p-rivero/CESCA/CESC Computer/README.md

# CESC Computer

This is the first iteration of the CESC computer. It's built on breadboards, and it's heavily inspired by Ben Eater's SAP-1 computer (the clock module and decimal decoder are identical).

The clock speed can be adjusted (with a potentiometer) up to **80 kHz**, but the circuit should be able to run at much higher speeds (however, that would require a crystal oscillator instead of the limited 555 circuit).

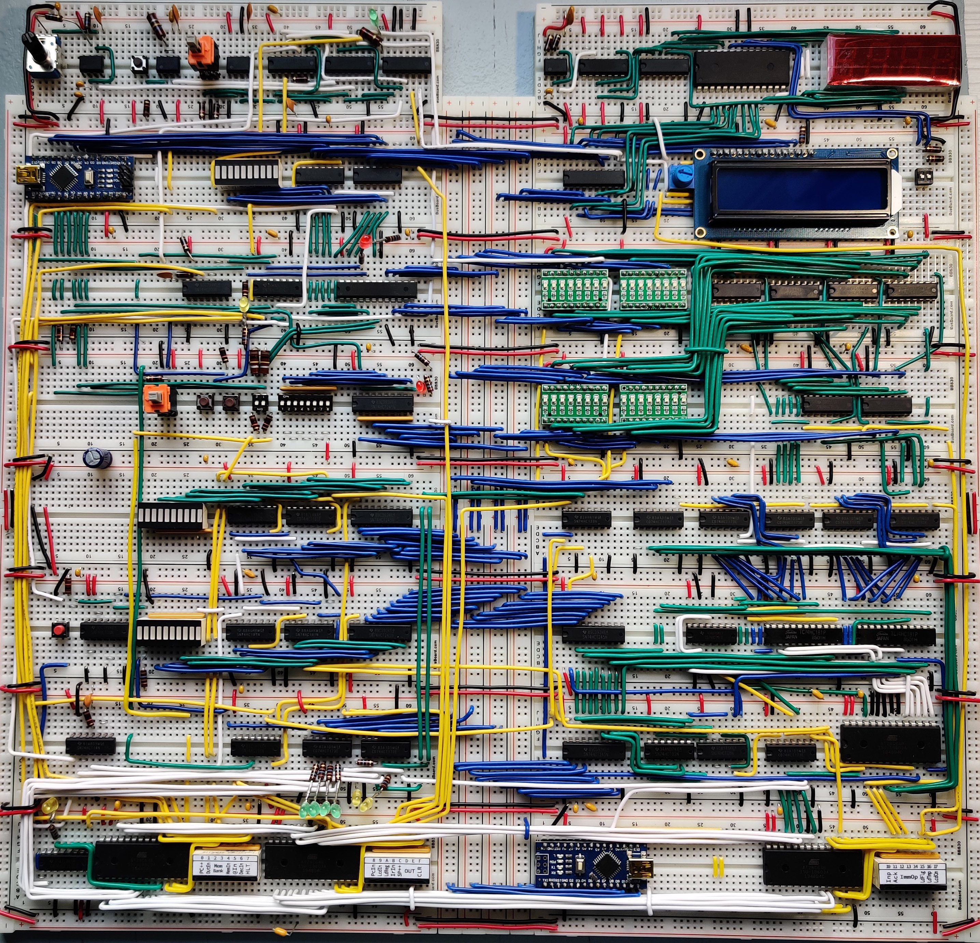
[picture p1: CESC Computer/Pictures/Computer.jpg]
Computer


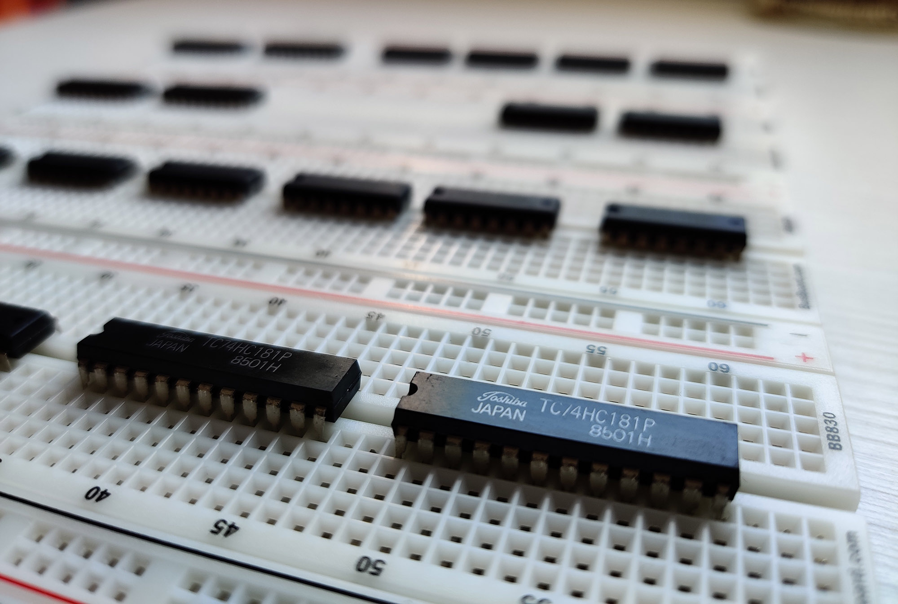
[picture p2: CESC Computer/Pictures/ALU_Chips.jpg]
Computer


## Modules

Just like in Ben Eater's design, the computer is split in several modules that are connected to a main bus in the middle.

However, unlike the SAP-1, my computer does make use of microcontrollers for I/O. Some will say this is cheating, but I'm allowing it because the CPU itself is still made out of discrete logic chips (it works just fine without any microcontroller, it's just that the I/O is less convenient).

- Arduino Nano for programming the RAM (instead of having to use the DIP switches)
- Arduino Nano for interfacing with a PS/2 keyboard
- LCD module (like the one used in Ben Eater's 6502 series)

Computer modules

## PS/2 Keyboard demo

Computer modules
