p-rivero/CESCA/CESC Computer/Control labels/README.md

# Control labels

This image is meant to be printed and then taped on top of the 10 segment bar graphs for the control word.
It's based on the [8bit-labels by w3arycod3r](https://github.com/w3arycod3r/8bit-labels).

**Warning**: Unlike the original labels, the size of this file isn't the real size of the bar graphs. Using "Actual size" in Adobe Reader isn't enough.

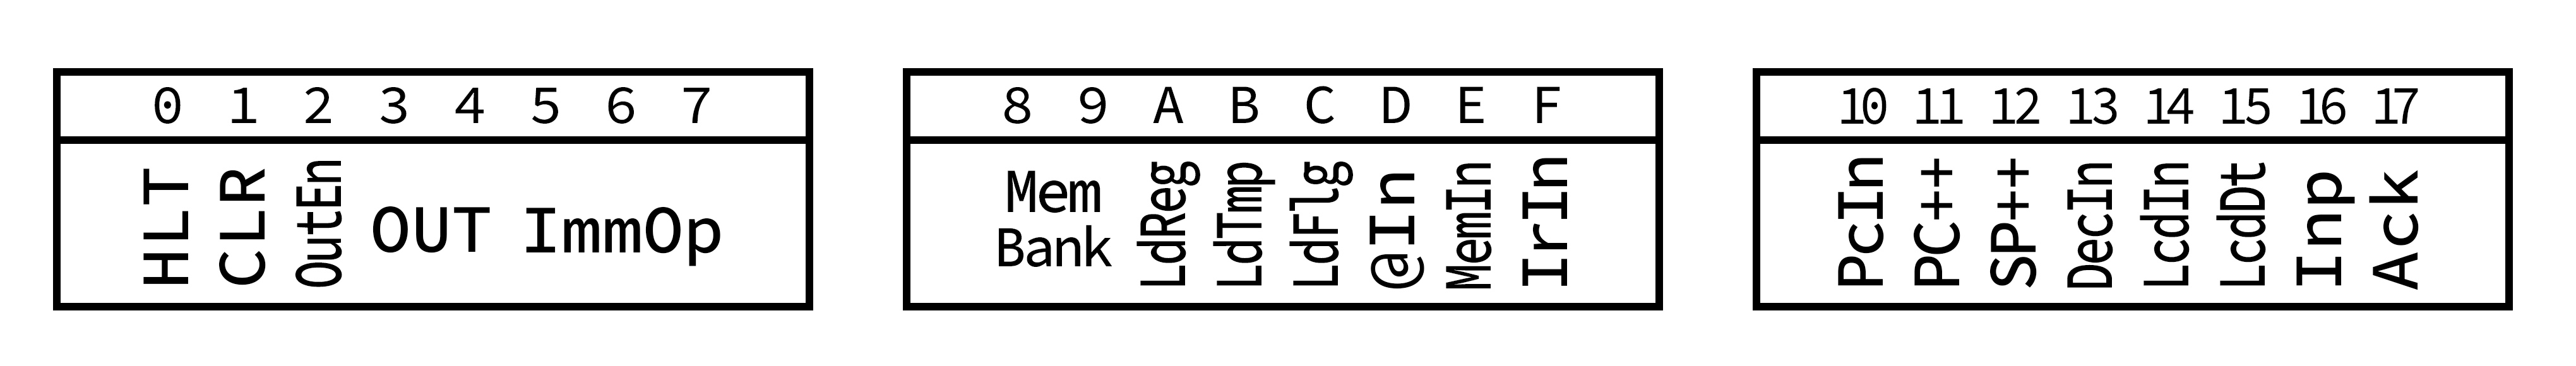
[picture p6: CESC Computer/Control labels/control labels.jpg]
Control labels


## New distribution

In order to greatly improve wiring, the distribution of the signals inside the EEPROMs has been changed. The new labels can be found in the `New distribution` folder.

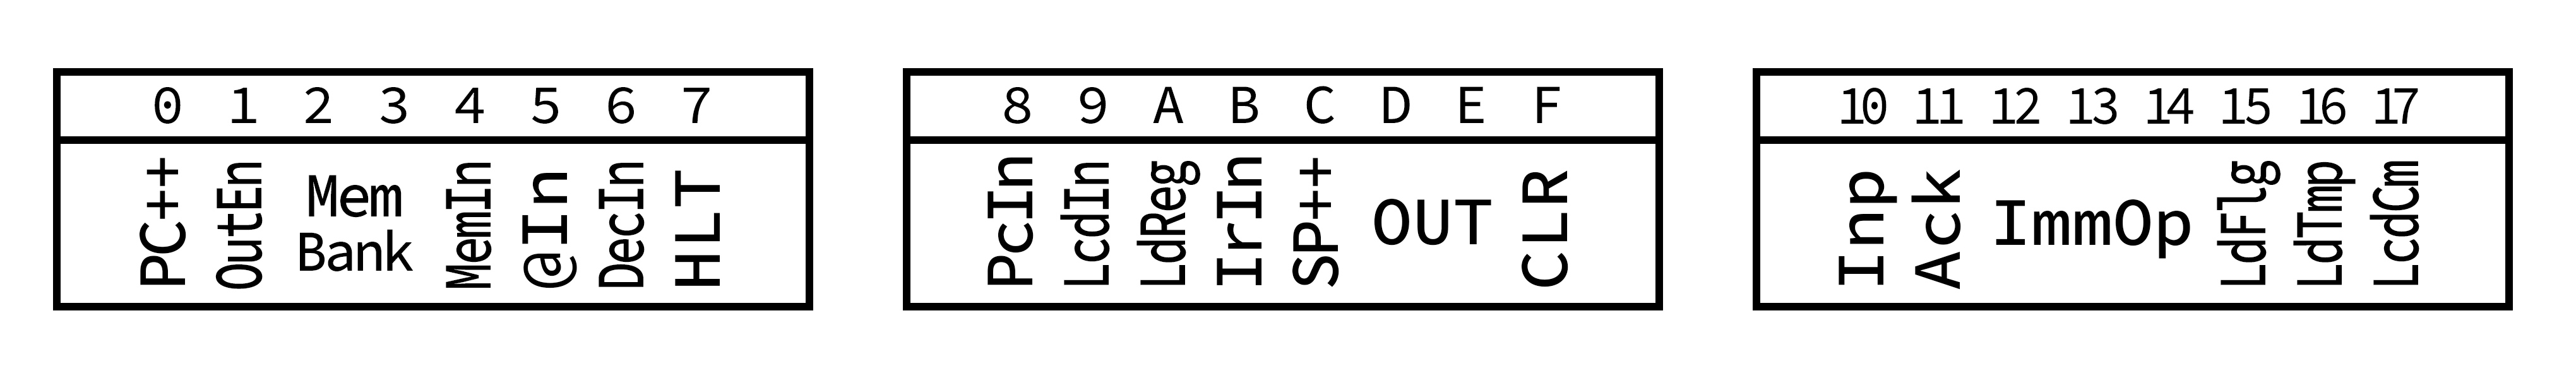
[picture p7: CESC Computer/Control labels/New distribution/control labels.jpg]
New control labels
