p-rivero/CESCA/Documentation/Keyboard_interface.pdf

# CESCA Keyboard Interface:

Contents of the keyboard controller:

Invalid input: No key has been pressed since the last check, or it’s still being processed. This state can be easily detected using maskIN,0xFF followed by a jz.

ASCII character: The pressed key corresponds to an ASCII character. If the input expected a number, you can subtract 48 (ASCII code for ‘0’) to the input. Note the following:
- The NULL character is interpreted as the invalid input.
- The Enter key is considered a special key instead of the ASCII code for CR or LF.
- The Backspace (delete) key is considered a special key instead of the ASCII code for BS or DEL.
- The input gets triggered when the key is pressed down

Special keys: If a program only expects to receive the arrow keys and other special keys, this format allows it to easily read them using an immediate mask.
- Special keys trigger twice: when it’s pressed down (make) and then when it’s lifted up (break).

Del = Backspace key or Delete key
Key Break: 0 = The key was pressed down (make) 1 = The key was lifted up (break)

Typematic Repeat: If a key is kept down, the keyboard will continue sending keystrokes at regular intervals. This affects both ASCII and Special keys, but the Key Break of special keys will always be sent only once.

Keypress buffer: The Arduino keyboard controller has an input buffer, so an input can be accepted even if previous ones are still being processed. The input buffer can be wiped by restarting the Arduino.

Input register (8 bits)

0 | 0 | 0 | 0 | 0 | 0 | 0 | 0

Input register (8 bits)

0 | ASCII code (7 bits)

Input register (8 bits)

1 | Key Break | Enter | Del

Generic input controller:
The computer can accept input from any device, as long as its controller meets these requirements:
- Must appear as a register: The computer expects an 8 bit “Input register”, with outputs connected directly to the bus and in a high impedance state by default.
- Invalid input: If Input register contains 0x00 as its value, the input is considered invalid. This means the user hasn’t entered any input yet, or that the controller is still processing it. The controller can decide how to represent its data using 8 bits, as long as it’s not with a 0x00.
- Takes 2 control signals:
- Inp (Input): Output enable signal for the Input register. The contents of the register are published to the bus for as long as Inp is high.
- Ack (Acknowledge): When Ack is high, the computer is indicating that it has finished processing the current input. The contents of the Input register must get set to 0x00 and the controller can start accepting a new input, or processing the next input in its buffer. Note that Ack will only be active if the current contents of the Input register aren’t 0x00, and Ack and Inp will never be active at the same time.
- Timing: The controller must follow these timing requirements:
- Enable output: The contents of the bus will be read half a clock cycle after the Inp signal gets set to high.
- Disable output: After the Inp signal gets set to low, the computer waits one clock cycle before writing anything to the bus to avoid bus contention.
- Ack hold time: The Ack signal stays high for exactly one clock cycle. The check frequency of the controller needs to be higher than the computer clock to avoid missing it. Also, the controller should make sure it only interprets the Ack once (by waiting until Ack is low again) to avoid skipping an input.
- Ack to Inp: When Ack changes from high to low, the Inp signal will stay low for at least two clock cycles. By then, the contents of the Input register must be either 0x00 or the next input.
With the slow clock speeds of such a simple architecture, I expect the controller to be orders of magnitude faster than the computer, so there shouldn’t be any timing problem. Of course, using interrupts would be a much more robust solution.

All those requirements can be accomplished using a real register and some logic ICs (for simple devices), or with an Arduino faking to be a register (for complex devices such as a keyboard).
