p-rivero/CESCA/Documentation/LCD_interface.pdf

# CESCA LCD Interface:

Commands for the LCD Module:

Name | Command (8 bits) | Description
Display clear | 0 | 0 | 0 | 0 | 0 | 0 | 0 | 1 | Clears display and restores the shift
Cursor home | 0 | 0 | 0 | 0 | 0 | 0 | 1 | X | Restores the cursor and display shift
Entry mode set | 0 | 0 | 0 | 0 | 0 | 1 | I/D | S | Sets direction of shift and cursor movement
Display ON/OFF | 0 | 0 | 0 | 0 | 1 | D | C | B | Turns on/off display, cursor and blink
Display shift | 0 | 0 | 0 | 1 | S/C | R/L | X | X | Shifts display or moves cursor ¹
Function set | 0 | 0 | 1 | 1 | N | F | X | X | Sets font and number of lines ²
Write to Char. Generator | 0 | 1 | C.G. Address | | | | | | Sets the Character Generator address ³
address Write to | 1 | Display Address | | | | | | | Sets the display address ³

X = Don’t care
I/D = Increment (1) / Decrement (0) | S = Shift ON (1) / OFF (0)
D = Display ON (1) / OFF (0) | C = Cursor ON (1) / OFF (0) | B = Cursor blink (1) / static (0)
S/C = Move display (1) / cursor (0) | R/L = Shift right (1) / left (0)
N = 2 lines (1) / 1 line (0) | F = Font size: 10 dots (1) / 8 dots (0)

1
Keep in mind “Display shift” is just for a one-time movement and doesn’t change the settings for future characters. The correct command for that purpose is “Entry mode set”.

2
The parameters of the “Function set” command depend on the hardware of the LCD screen, so those will remain constant in all programs. The 4th bit is always 1 since data length is always 8 bits.

3
After a “Write to Character Generator” or “Write to address” command, an LCD data instruction must be performed (LCD-Imm, LCD-Reg or LCD-Mem). This data will be written to the address indicated in the command.

Characters for the LCD Module:

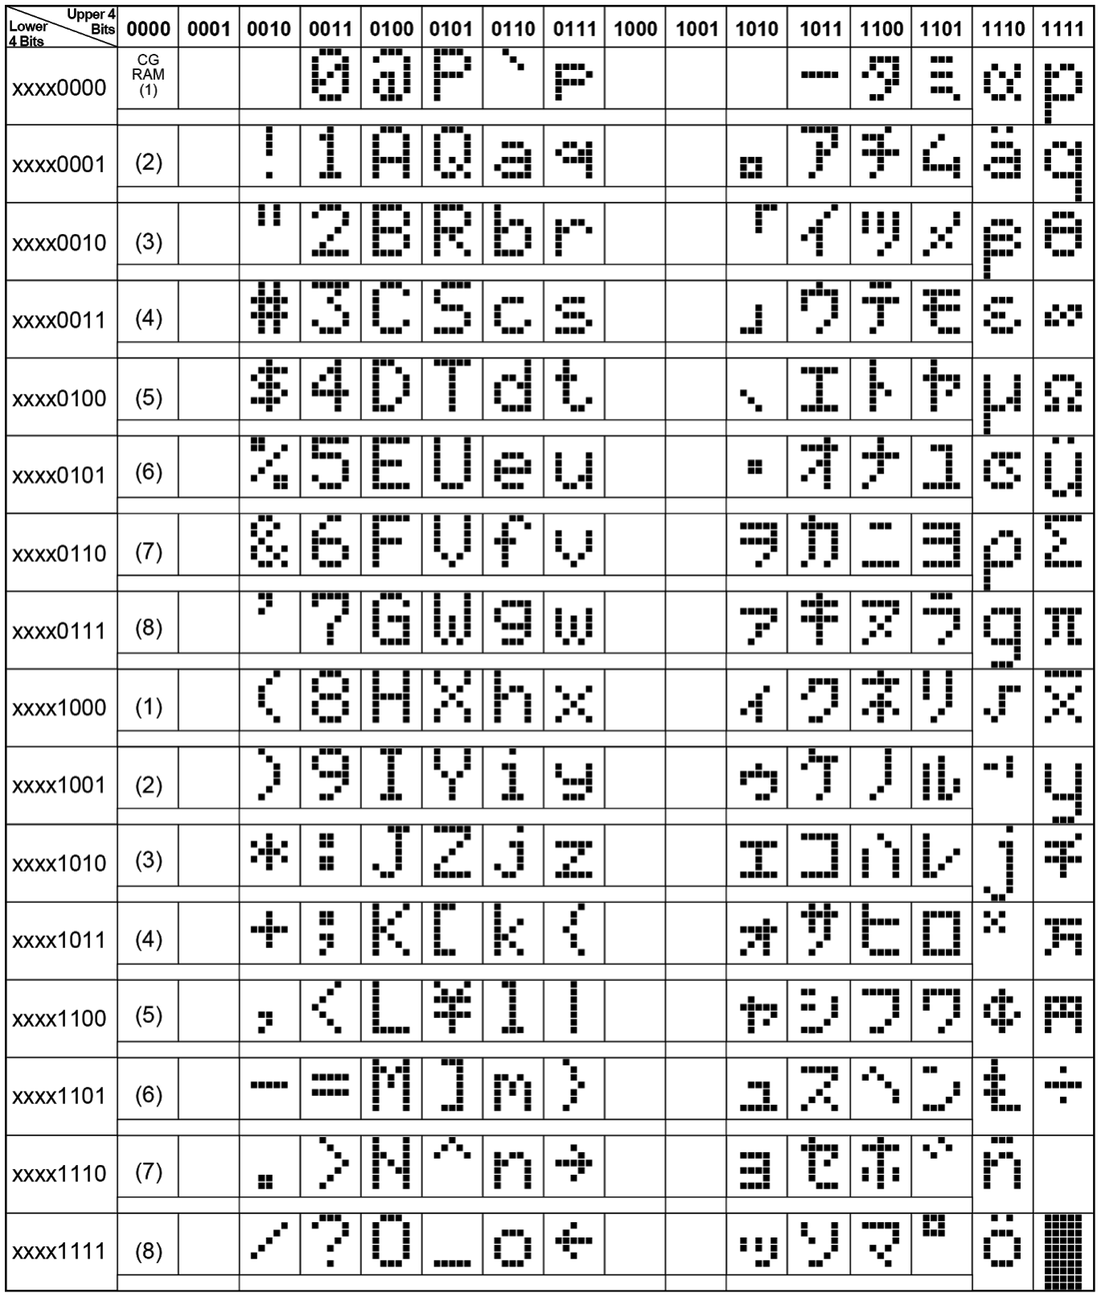
[picture p9: figure]
