p-rivero/CESCA/CESC Computer/Pictures/Control_Labels.jpg

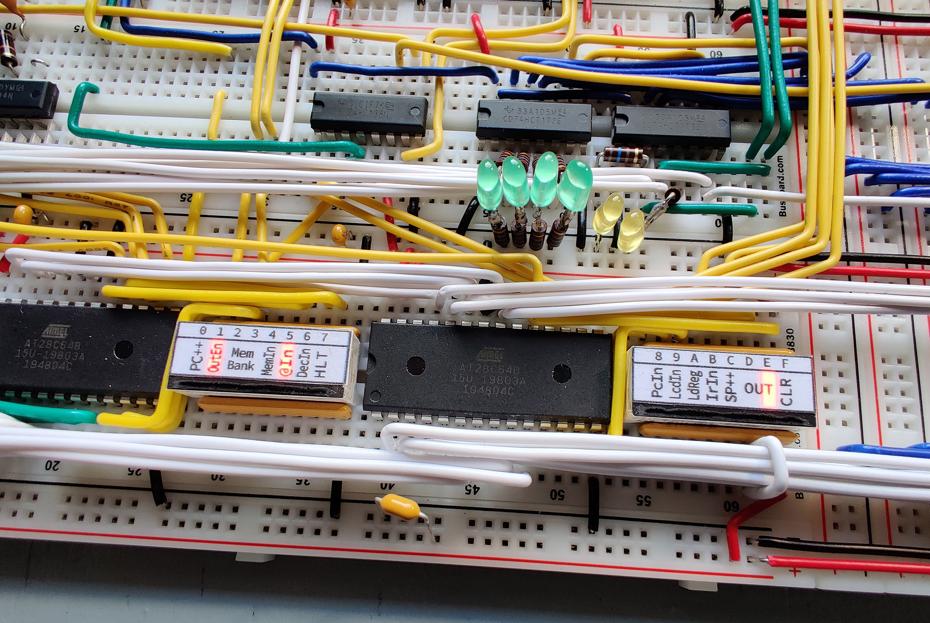
CESC Computer/Pictures/Control_Labels.jpg
