p-rivero/CESCA/Assembly/Useful extras/README.md

# Assembly extras

## cesca_syntax.xml

This file provides custom syntax highlighting in Notepad++ for proramming in CESCA assembly. How to use:
 1. Open Notepad++ and go to Language -> User Defined Language -> Define your language
 2. Click "Import..." and select cesca_syntax.xml
 3. *(OPTIONAL)* Go to Settings -> Style configurator and select the theme you prefer. I recommend using *Zenburn*
 4. Restart Notepad++
 
Now the custom language "CESCA" is associated with .asm files in Notepad++. The coloring of your code should look similar to this:

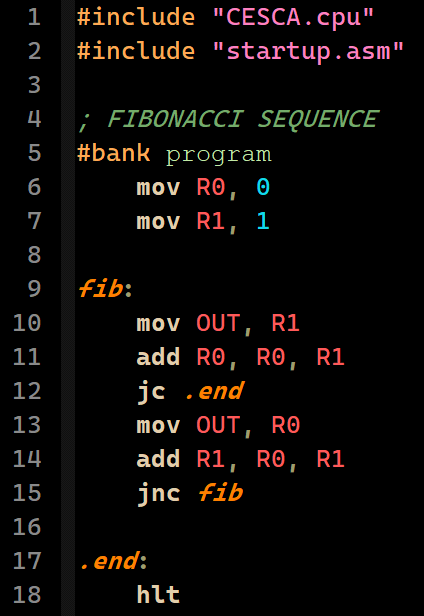
[picture p11: Assembly/Useful extras/syntax example.png]
Syntax highlighting
