p-rivero/CESCA/CESC Computer/High level overview.pdf

### LCD MODULE

### Output Reg. MAR

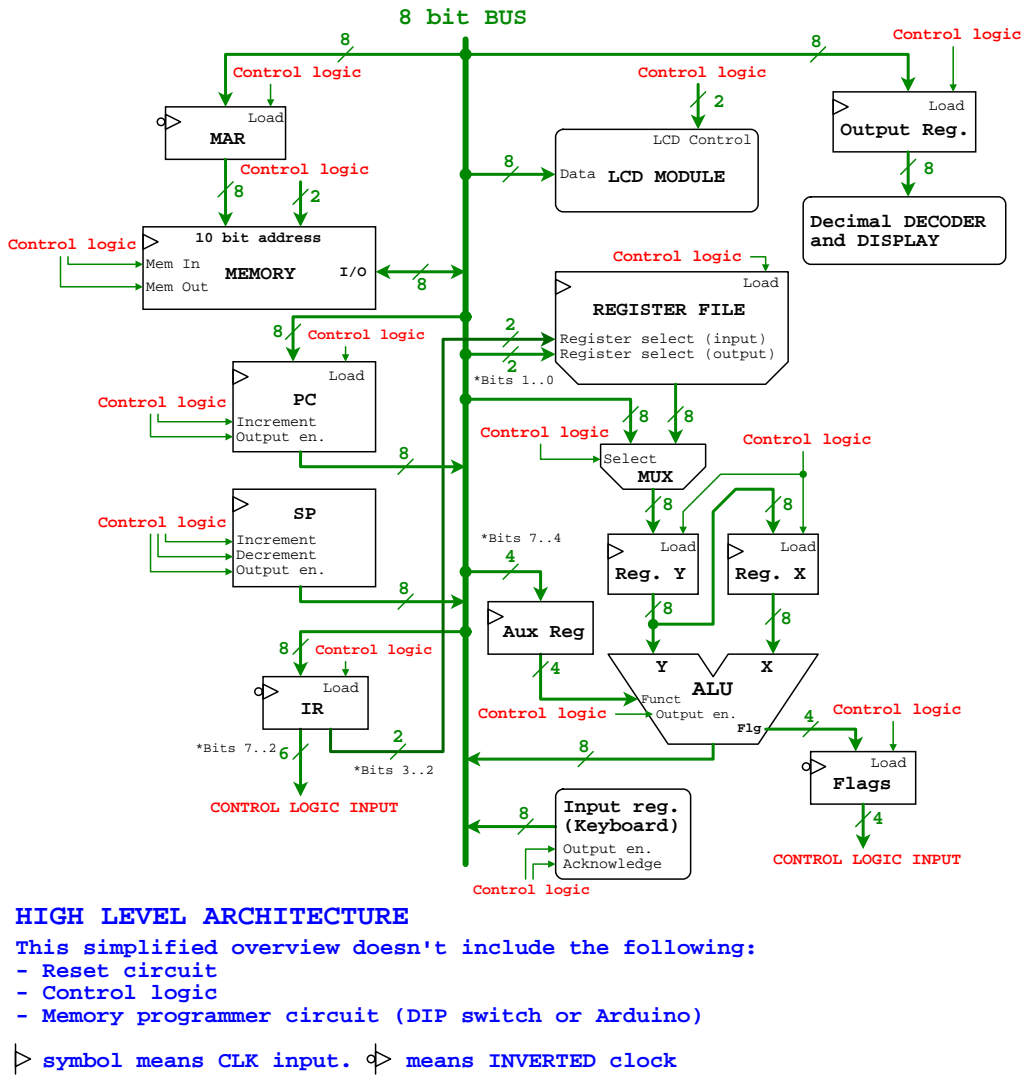
[picture p12: page 1]

HIGH LEVEL ARCHITECTURE
This simplified overview doesn't include the following:
- Reset circuit
- Control logic
- Memory programmer circuit (DIP switch or Arduino)
