p-rivero/CESCA/CESC Computer/EEPROM Programmer/Microcode/Pin connections.pdf

LdFlg .......+--+-+

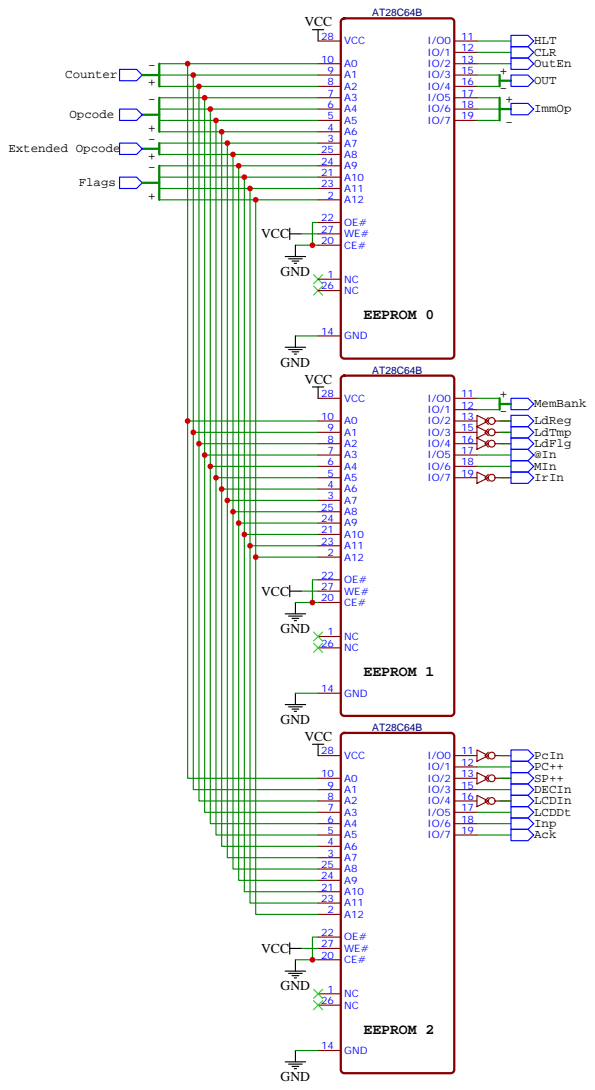
[picture p13: page 1]
