p-rivero/CESCA/CESC Computer/EEPROM Programmer/Decimal display/Pin connections.pdf

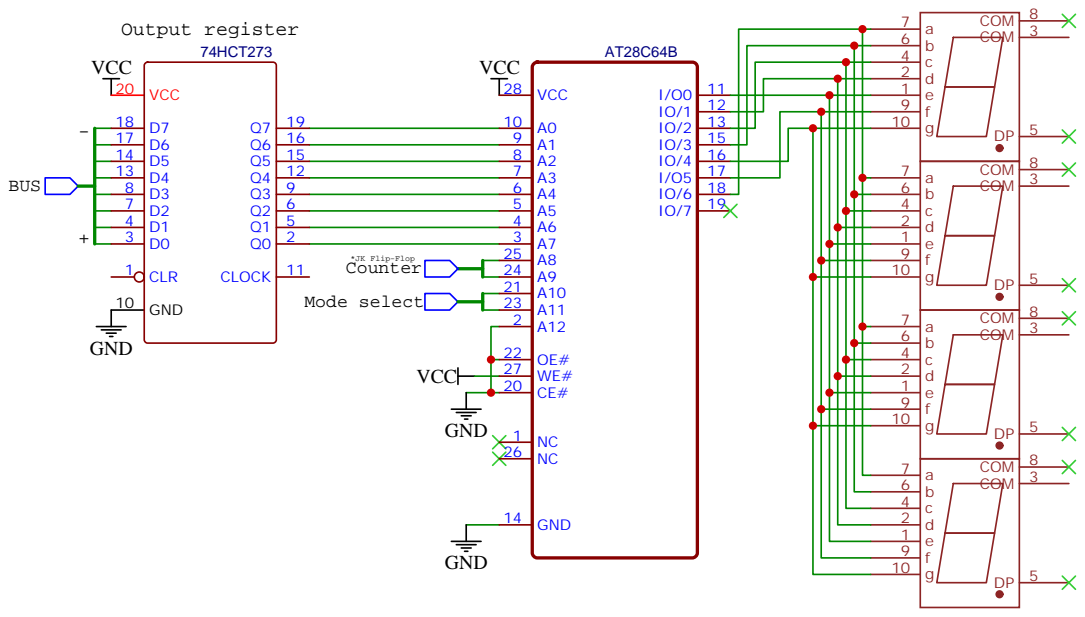
[picture p14: page 1]
