p-rivero/CESCA/CESC Computer/EEPROM Programmer/ALU/Pin connections.pdf

## VCC

# 74HC181 12GND VCC24

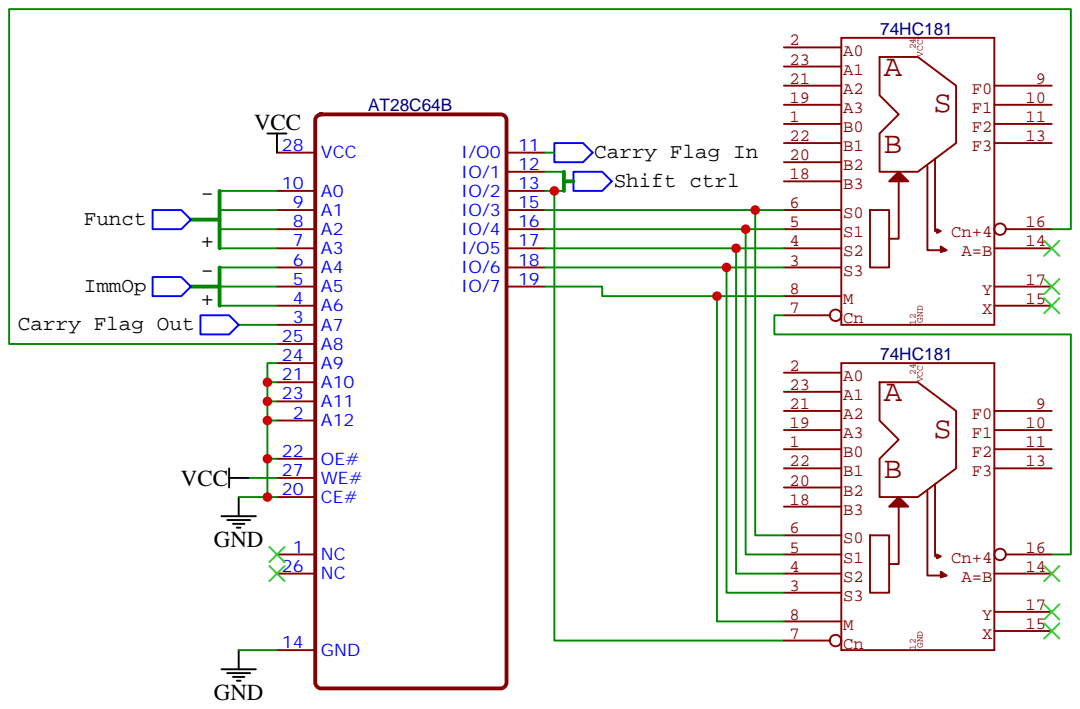
[picture p15: page 1]
