p-rivero/CESCA/CESC Computer/EEPROM Programmer/Microcode/New distribution/Pin connections.pdf

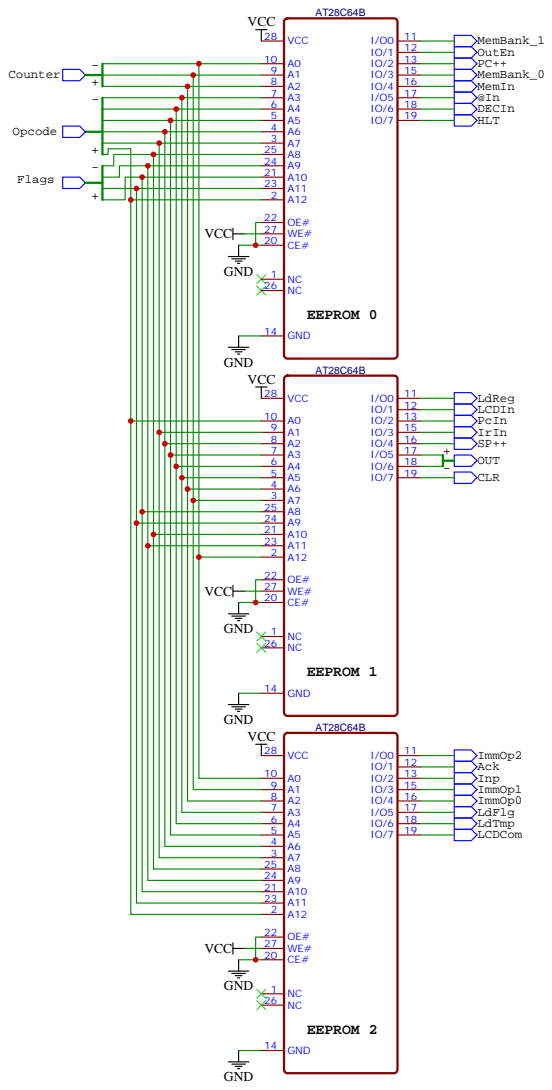
[picture p16: page 1]
