p-rivero/CESCA/(commit log)

2020-06-11 Switched to Arduino data types
2020-08-16 The RAM programmer has been added
    Added code for Arduino and PC that allows sending assembly programs (written on your PC) to the breadboard computer
2020-08-17 Simplified cpudef
    The assembly output is unchanged
2020-09-20 Added new distribution for Control EEPROMs
    Inputs and outputs of all EEPROMs have been modified to make wiring much easier
2021-01-01 Fixed a wiring issue in software
2021-01-03 Added assembly preprocessor using cpp
2021-01-03 Started implementing new assembly syntax
    The current assembly programs have been copied to the "Old Syntax" folder.
    The programs and documentation will soon be translated using the new syntax. Read "Old Syntax/README.md" for more info.
2021-01-04 Finished translating assembly programs into new syntax
2021-01-06 Switched to a more permissive license
2021-01-11 Added preprocessor support when sending programs
    In order to send programs to the Arduino RAM programmer, please use the new script (send.sh).
2021-01-22 Added new PRINT library
2021-01-22 Improvements to PRINT library
2021-01-26 Added new routine for printing strings
